adamalfath/sentsor-core-wroom32u/media/core32u-extra0.png

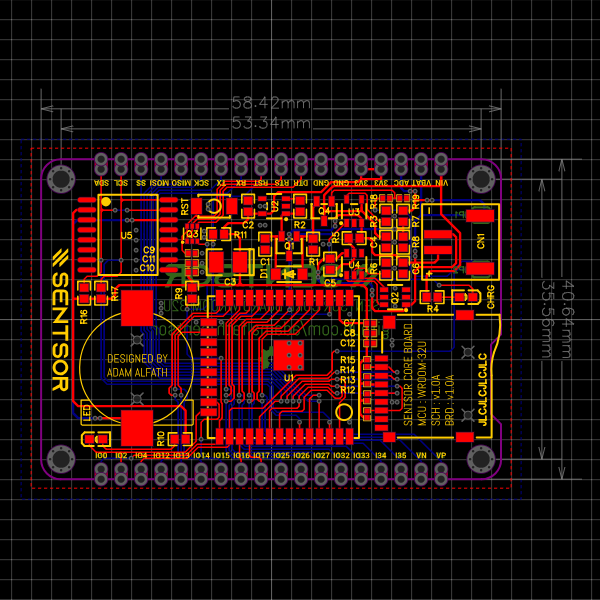
media/core32u-extra0.png
