adamalfath/sentsor-core-wroom32u/media/core32u-extra1.png

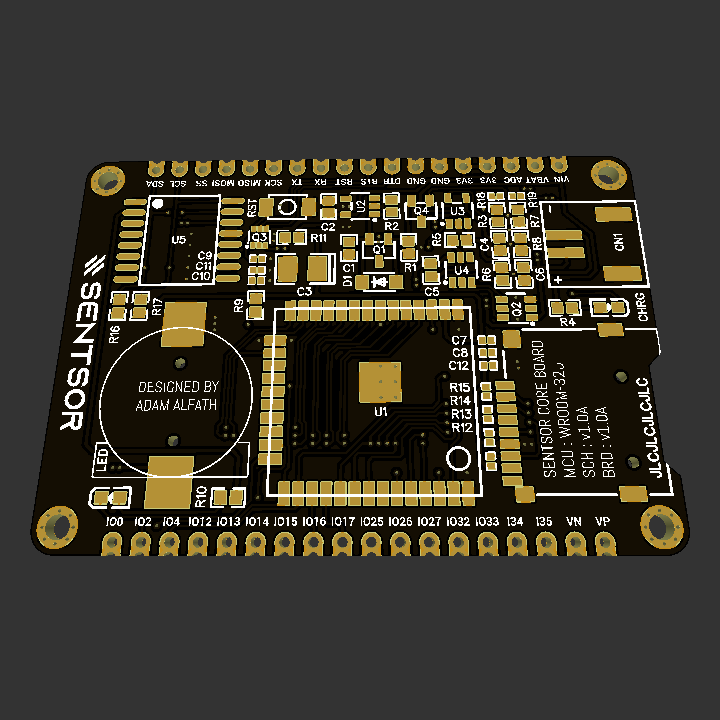
media/core32u-extra1.png
