adamalfath/sentsor-core-wroom32u/media/core32u-extra2.png

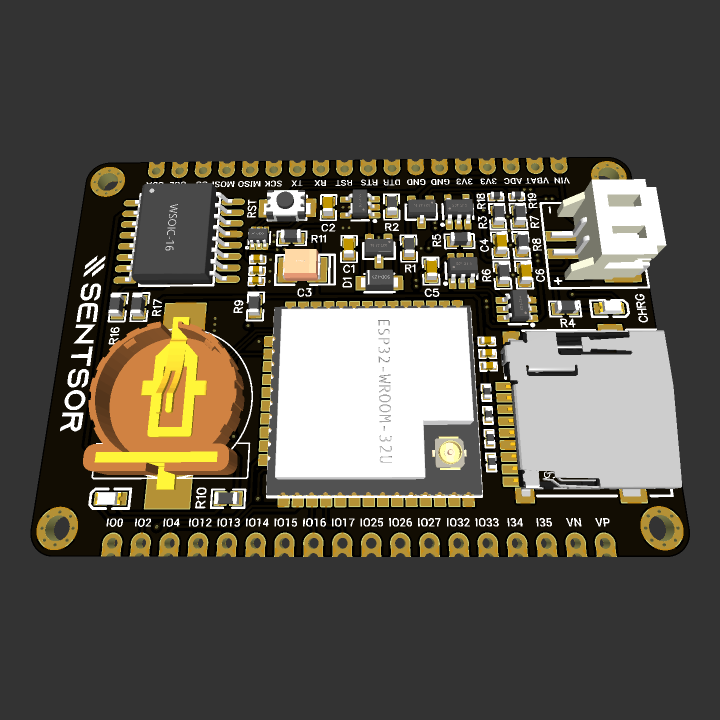
media/core32u-extra2.png
