adamalfath/sentsor-core-wroom32u/media/core32u-extra3.jpg

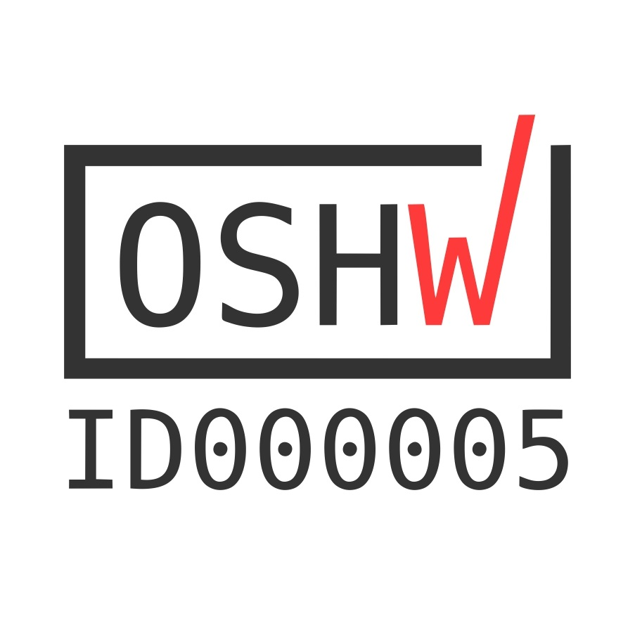
media/core32u-extra3.jpg
