adamalfath/sentsor-core-wroom32u/media/core32u-extra4.jpg

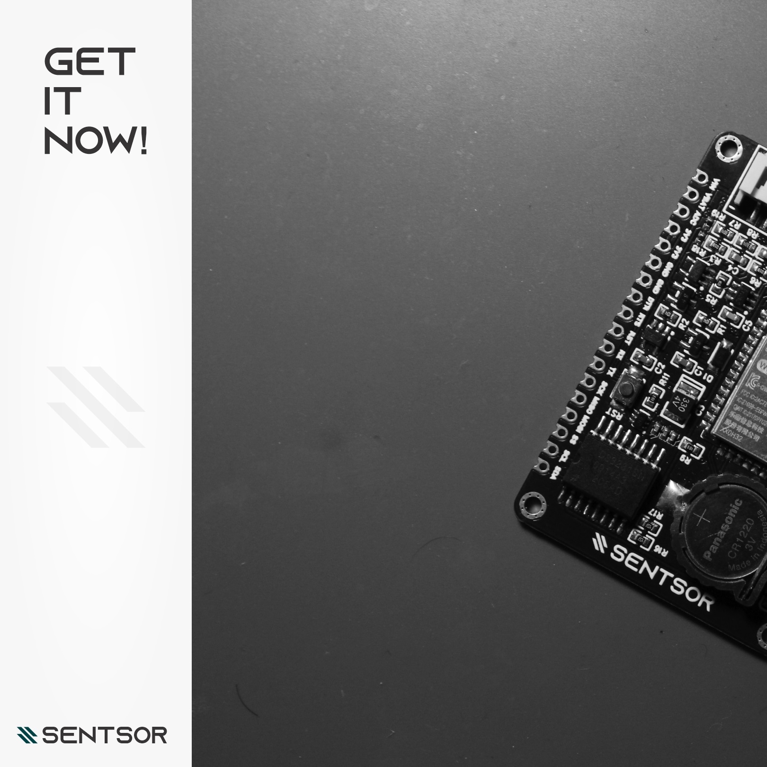
media/core32u-extra4.jpg
