adamalfath/sentsor-core-wroom32u/media/core32u-extra5.jpg

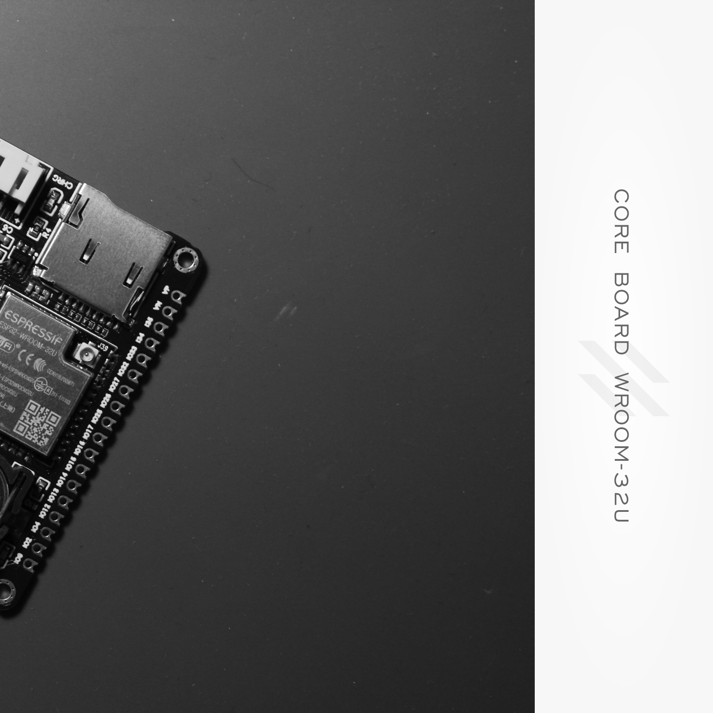
media/core32u-extra5.jpg
