adamalfath/sentsor-core-wroom32u/media/OSHW_mark_ID000005.png

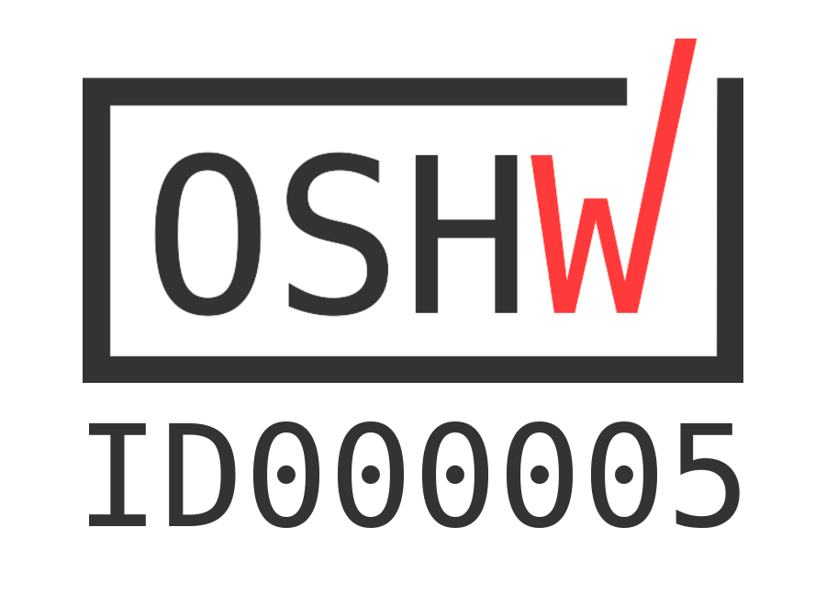
media/OSHW_mark_ID000005.png
