adamalfath/sentsor-core-wroom32u/media/sq/core32u-img0sq.jpg

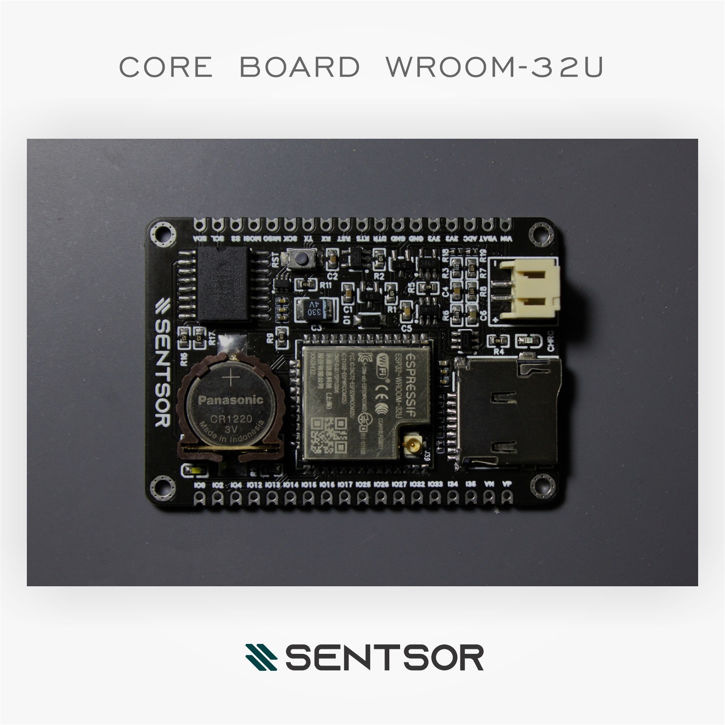
media/sq/core32u-img0sq.jpg
