adamalfath/sentsor-core-wroom32u/media/sq/core32u-img1sq.jpg

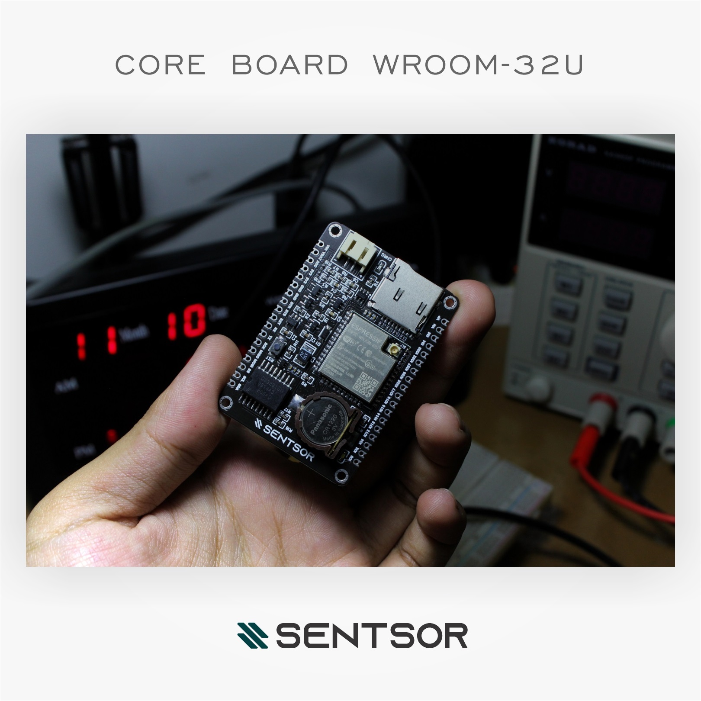
media/sq/core32u-img1sq.jpg
