adamalfath/sentsor-core-wroom32u/media/sq/core32u-img2sq.jpg

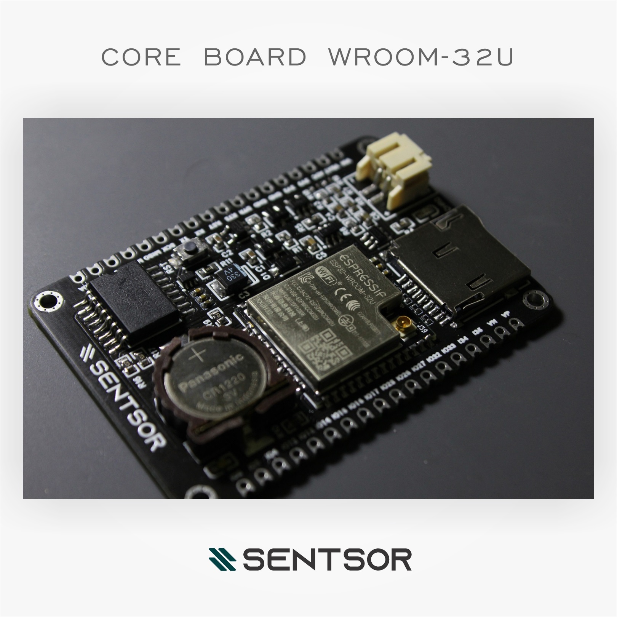
media/sq/core32u-img2sq.jpg
