adamalfath/sentsor-core-wroom32u/media/sq/core32u-img3sq.jpg

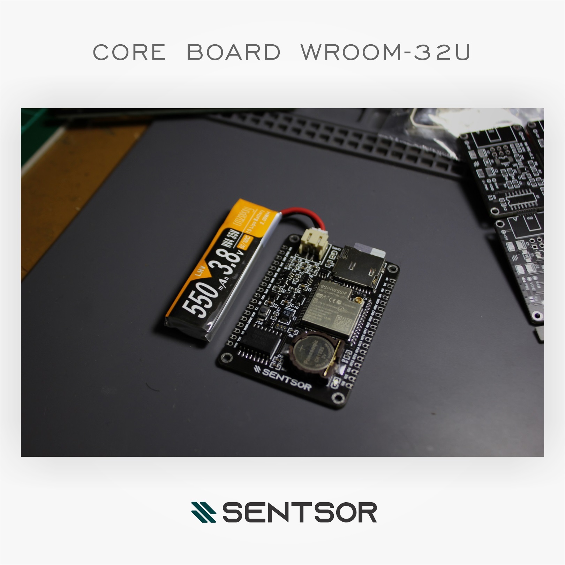
media/sq/core32u-img3sq.jpg
