adamalfath/sentsor-core-wroom32u/media/sq/core32u-img4sq.jpg

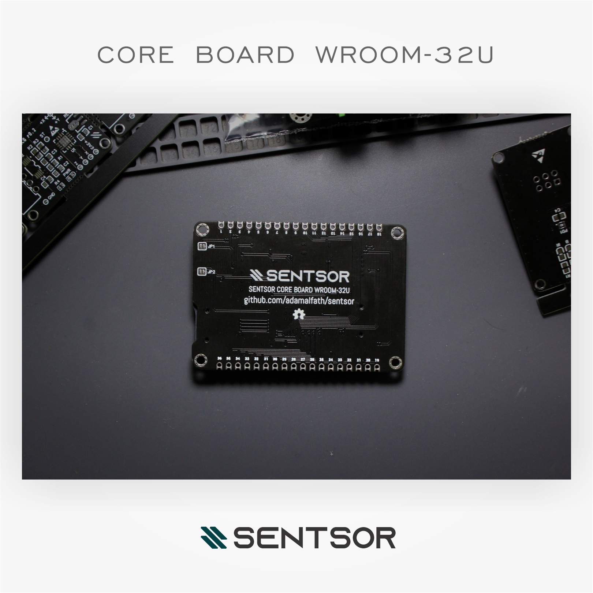
media/sq/core32u-img4sq.jpg
