adamalfath/sentsor-core-wroom32u/Schematic_SENTSOR CORE WROOM-32U.pdf

## REGULATOR

## CHARGER & PROTECTION

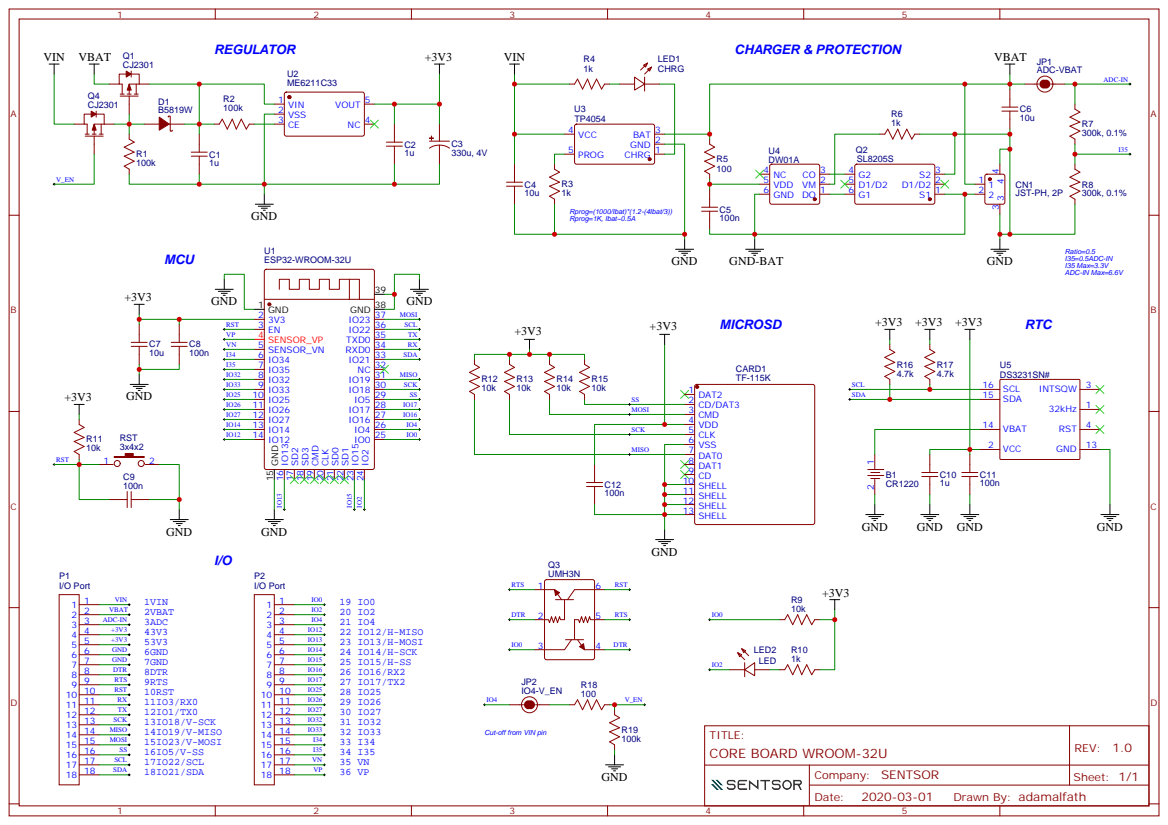
[picture p24: page 1]

Cut-off from VIN pin
